gustavostuff/makineat/img/references/AI_concept_v_04.jpg

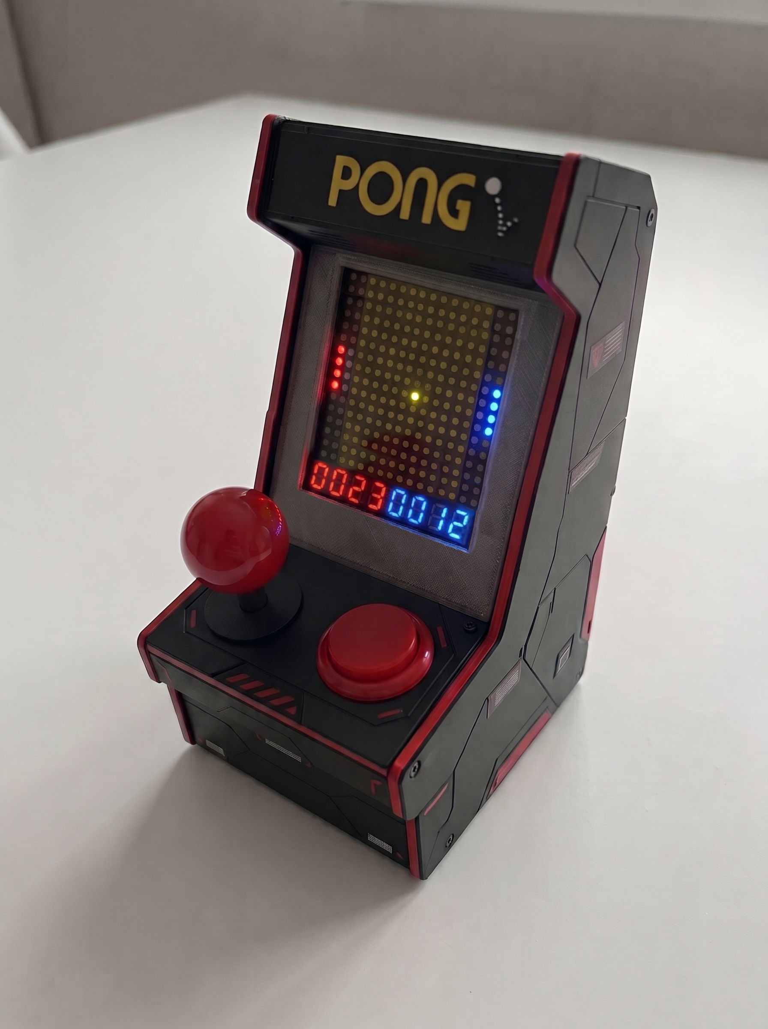
img/references/AI_concept_v_04.jpg
