gustavostuff/makineat/tools/kicad/cart-pcb/makineat-cart_v_02.png

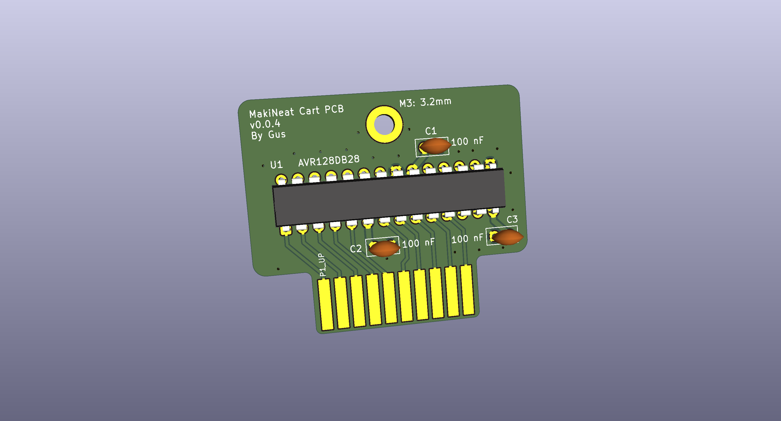
tools/kicad/cart-pcb/makineat-cart_v_02.png
