gustavostuff/makineat/tools/kicad/cart-pcb/makineat-cart_v_02.kicad_pcb

## KiCad design tools/kicad/cart-pcb/makineat-cart_v_02.kicad_pcb (2026-11-09)

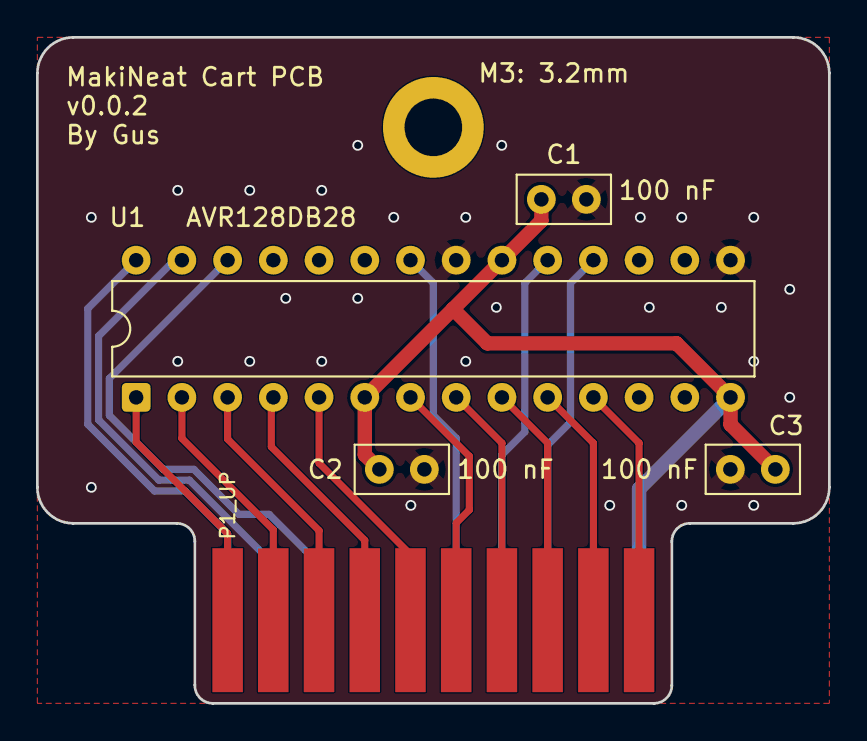
[picture p13: board makineat-cart_v_02.kicad_pcb from above]

Board: 2 copper layers, 44.0 x 37.0 mm, 6 parts (0 on the bottom side), 18 nets.

Parts:
C1, C2, C3: 100 nF; C_Disc_D5.0mm_W2.5mm_P2.50mm
Hole: M3: 3.2mm; MountingHole_3.2mm_M3_DIN965_Pad
J1: Cart edge 2x10; Cart_Edge_2x10_P2.54mm
U1: AVR128DB28; DIP-28_W7.62mm

Connections:
+5V: C1.1, C2.1, C3.1, J1.B10, U1.6, U1.14, U1.20
CLK: J1.B1, U1.28
DIN: J1.B3, U1.26
EVENT: J1.B8, U1.18
GND: C1.2, C2.2, C3.2, J1.B4, J1.B5, J1.B9, U1.15, U1.21
LOAD: J1.B2, U1.27
P1_BTN: J1.A5, U1.5
P1_DOWN: J1.A2, U1.2
P1_LEFT: J1.A3, U1.3
P1_RIGHT: J1.A4, U1.4
P1_UP: J1.A1, U1.1
P2_BTN: J1.A10, U1.11
P2_DOWN: J1.A7, U1.8
P2_LEFT: J1.A8, U1.9
P2_RIGHT: J1.A9, U1.10
P2_UP: J1.A6, U1.7
RESET: J1.B7, U1.19
UPDI: J1.B6, U1.22
