gustavostuff/makineat/tools/sim/seven_seg.c

#include "seven_seg.h"

#include "chips/max7219.h"

static SevenSegLayerBlitFn layer_blit;

#include <SDL_image.h>
#include <stdio.h>
#include <string.h>

static SDL_Texture *load_layer(SDL_Renderer *renderer, const char *name)
{
    char path[1024];
    char *base = SDL_GetBasePath();
    SDL_Surface *surface;
    SDL_Texture *tex;

    if (base != NULL) {
        snprintf(path, sizeof path, "%simg/7_segment_display_layers/%s", base, name);
        surface = IMG_Load(path);
        if (surface == NULL) {
            snprintf(path, sizeof path, "%s../sim/img/7_segment_display_layers/%s", base, name);
            surface = IMG_Load(path);
        }
        SDL_free(base);
    } else {
        surface = NULL;
    }
    if (surface == NULL) {
        snprintf(path, sizeof path, "tools/sim/img/7_segment_display_layers/%s", name);
        surface = IMG_Load(path);
    }
    if (surface == NULL) {
        SDL_Log("seven_seg IMG_Load %s failed: %s", name, IMG_GetError());
        return NULL;
    }
    tex = SDL_CreateTextureFromSurface(renderer, surface);
    SDL_FreeSurface(surface);
    if (tex != NULL)
        SDL_SetTextureScaleMode(tex, SDL_ScaleModeNearest);
    return tex;
}

static int texture_size(SDL_Texture *tex, int *w, int *h)
{
    if (tex == NULL || w == NULL || h == NULL)
        return -1;
    if (SDL_QueryTexture(tex, NULL, NULL, w, h) != 0)
        return -1;
    return 0;
}

static int layer_matches_digit(const SevenSegDisplay *disp, SDL_Texture *tex, const char *name)
{
    int w;
    int h;

    if (texture_size(tex, &w, &h) != 0)
        return -1;
    if (w != disp->digit_w || h != disp->digit_h) {
        SDL_Log("seven_seg layer %s is %dx%d, expected %dx%d", name, w, h, disp->digit_w,
                disp->digit_h);
        return -1;
    }
    return 0;
}

void seven_seg_set_layer_blit(SevenSegLayerBlitFn fn)
{
    layer_blit = fn;
}

int seven_seg_init(SevenSegDisplay *disp, SDL_Renderer *renderer)
{
    static const char *seg_files[7] = {
        "a.png", "b.png", "c.png", "d.png", "e.png", "f.png", "g.png",
    };
    int i;

    memset(disp, 0, sizeof *disp);
    disp->base = load_layer(renderer, "all_off.png");
    if (disp->base == NULL)
        return -1;
    if (texture_size(disp->base, &disp->digit_w, &disp->digit_h) != 0)
        return -1;
    for (i = 0; i < 7; i++) {
        disp->seg[i] = load_layer(renderer, seg_files[i]);
        if (disp->seg[i] == NULL)
            return -1;
        if (layer_matches_digit(disp, disp->seg[i], seg_files[i]) != 0)
            return -1;
    }
    disp->dp = load_layer(renderer, "dp.png");
    if (disp->dp == NULL)
        return -1;
    if (layer_matches_digit(disp, disp->dp, "dp.png") != 0)
        return -1;
    seven_seg_clear(disp);
    return 0;
}

void seven_seg_quit(SevenSegDisplay *disp)
{
    int i;

    if (disp->base != NULL) {
        SDL_DestroyTexture(disp->base);
        disp->base = NULL;
    }
    for (i = 0; i < 7; i++) {
        if (disp->seg[i] != NULL) {
            SDL_DestroyTexture(disp->seg[i]);
            disp->seg[i] = NULL;
        }
    }
    if (disp->dp != NULL) {
        SDL_DestroyTexture(disp->dp);
        disp->dp = NULL;
    }
}

void seven_seg_clear(SevenSegDisplay *disp)
{
    memset(disp->mask, 0, sizeof disp->mask);
}

void seven_seg_set_mask(SevenSegDisplay *disp, int digit, uint8_t mask)
{
    if (digit < 0 || digit >= SEVEN_SEG_DIGITS)
        return;
    disp->mask[digit] = mask;
}

uint8_t seven_seg_get_mask(const SevenSegDisplay *disp, int digit)
{
    if (digit < 0 || digit >= SEVEN_SEG_DIGITS)
        return 0;
    return disp->mask[digit];
}

uint8_t seven_seg_mask_from_max7219(uint8_t segment_byte)
{
    uint8_t mask = 0;

    if ((segment_byte & 0x40) != 0)
        mask |= SEVEN_SEG_A;
    if ((segment_byte & 0x20) != 0)
        mask |= SEVEN_SEG_B;
    if ((segment_byte & 0x10) != 0)
        mask |= SEVEN_SEG_C;
    if ((segment_byte & 0x08) != 0)
        mask |= SEVEN_SEG_D;
    if ((segment_byte & 0x04) != 0)
        mask |= SEVEN_SEG_E;
    if ((segment_byte & 0x02) != 0)
        mask |= SEVEN_SEG_F;
    if ((segment_byte & 0x01) != 0)
        mask |= SEVEN_SEG_G;
    if ((segment_byte & 0x80) != 0)
        mask |= SEVEN_SEG_DP;
    return mask;
}

void seven_seg_sync_from_max7219(SevenSegDisplay *disp, const Max7219 *chip)
{
    int d;

    if (disp == NULL || chip == NULL)
        return;
    for (d = 0; d < SEVEN_SEG_DIGITS; d++)
        disp->mask[d] = seven_seg_mask_from_max7219(max7219_segment_byte(chip, d));
}

void seven_seg_sync_from_status_frame(SevenSegDisplay *disp, const uint8_t *frame, int n)
{
    int d;
    int count = n;

    if (disp == NULL || frame == NULL)
        return;
    if (count > SEVEN_SEG_DIGITS)
        count = SEVEN_SEG_DIGITS;
    for (d = 0; d < count; d++)
        disp->mask[d] = frame[d];
    for (; d < SEVEN_SEG_DIGITS; d++)
        disp->mask[d] = 0;
}

uint8_t seven_seg_encode_char(char c)
{
    return seven_seg_font_mask(c);
}

void seven_seg_put_char(SevenSegDisplay *disp, int digit, char c)
{
    seven_seg_set_mask(disp, digit, seven_seg_encode_char(c));
}

int seven_seg_print(SevenSegDisplay *disp, const char *text)
{
    int slot = 0;
    int last = -1;
    int n = 0;

    seven_seg_clear(disp);
    if (text == NULL)
        return 0;

    for (; *text != '\0' && slot < SEVEN_SEG_DIGITS; text++) {
        char c = *text;

        if (c == '.') {
            if (last >= 0)
                disp->mask[last] |= SEVEN_SEG_DP;
            continue;
        }
        disp->mask[slot] = seven_seg_encode_char(c);
        last = slot;
        slot++;
        n++;
    }
    return n;
}

static void blit_digit_layer(SDL_Renderer *renderer, SDL_Texture *tex, int x, int y, int src_w,
                             int src_h, int dst_w, int dst_h, int lit)
{
    SDL_Rect src = {0, 0, src_w, src_h};
    SDL_Rect dst = {x, y, dst_w, dst_h};

    if (tex == NULL || dst_w <= 0 || dst_h <= 0)
        return;
    if (layer_blit != NULL)
        layer_blit(renderer, tex, &src, &dst, lit);
    else
        SDL_RenderCopy(renderer, tex, &src, &dst);
}

void seven_seg_draw_digit(const SevenSegDisplay *disp, SDL_Renderer *renderer, int x, int y,
                          uint8_t mask, int scale)
{
    int bit;
    int src_w;
    int src_h;
    int dst_w;
    int dst_h;

    if (disp == NULL || disp->base == NULL || scale < 1)
        return;
    src_w = disp->digit_w;
    src_h = disp->digit_h;
    dst_w = src_w * scale;
    dst_h = src_h * scale;
    blit_digit_layer(renderer, disp->base, x, y, src_w, src_h, dst_w, dst_h, 0);
    for (bit = 0; bit < 7; bit++) {
        if ((mask & (1u << bit)) != 0)
            blit_digit_layer(renderer, disp->seg[bit], x, y, src_w, src_h, dst_w, dst_h, 1);
    }
    if ((mask & SEVEN_SEG_DP) != 0)
        blit_digit_layer(renderer, disp->dp, x, y, src_w, src_h, dst_w, dst_h, 1);
}

int seven_seg_row_width(const SevenSegDisplay *disp)
{
    if (disp == NULL || disp->digit_w <= 0)
        return 0;
    return disp->digit_w * SEVEN_SEG_DIGITS;
}

void seven_seg_draw(const SevenSegDisplay *disp, SDL_Renderer *renderer, int x, int y,
                    int canvas_w, int canvas_h)
{
    int i;
    SDL_Rect old;
    SDL_Rect clip = {0, 0, canvas_w, canvas_h};
    SDL_bool enabled;

    if (disp == NULL || disp->digit_w <= 0)
        return;

    enabled = SDL_RenderIsClipEnabled(renderer);
    SDL_RenderGetClipRect(renderer, &old);
    SDL_RenderSetClipRect(renderer, &clip);
    for (i = 0; i < SEVEN_SEG_DIGITS; i++)
        seven_seg_draw_digit(disp, renderer, x + i * disp->digit_w, y, disp->mask[i], 1);
    if (enabled)
        SDL_RenderSetClipRect(renderer, &old);
    else
        SDL_RenderSetClipRect(renderer, NULL);
}

int seven_seg_below_field_origin(const SevenSegDisplay *disp, int field_x, int field_y,
                                 int field_px, int grid_margin, int *out_x, int *out_y)
{
    int row_w;
    int avail;
    int x;
    int y;

    if (disp == NULL || disp->digit_w <= 0 || out_x == NULL || out_y == NULL)
        return -1;

    row_w = seven_seg_row_width(disp);
    y = field_y + field_px + grid_margin;
    avail = field_px - 2 * grid_margin;
    if (row_w <= avail)
        x = field_x + grid_margin + (avail - row_w) / 2;
    else
        x = field_x + (field_px - row_w) / 2;
    *out_x = x;
    *out_y = y;
    return 0;
}

void seven_seg_draw_below_field(const SevenSegDisplay *disp, SDL_Renderer *renderer,
                                int field_x, int field_y, int field_px, int grid_margin,
                                int canvas_w, int canvas_h)
{
    int x;
    int y;

    if (seven_seg_below_field_origin(disp, field_x, field_y, field_px, grid_margin, &x, &y) != 0)
        return;
    seven_seg_draw(disp, renderer, x + SEVEN_SEG_LAYER_X_OFFSET, y, canvas_w, canvas_h);
}
