gustavostuff/makineat/tools/fw/stage.h

#ifndef FW_STAGE_H
#define FW_STAGE_H

/*
 * Platform stages: wide/tall bitmaps with a scrolling camera over the 16x16
 * field. PNG import (tools/fw/gen_stage.py): pure colors on fg (see docs/firmware.md
 * Stage section). Optional bg parallax maps scroll spans so both layers start and
 * end together: bg moves (bg_width - 16) / (fg_width - 16) per fg camera step.
 * Horizontal mode is implemented. Vertical
 * mode is stubbed (STAGE_ERR_UNSUPPORTED).
 */

#include "frame.h"

#include <stdint.h>

#define STAGE_TICK_HZ 60
#define STAGE_SCROLL_FPS 30

/* Horizontal camera dead zone in screen space (see stage_h_camera_follow_dead_zone). */
#define STAGE_H_DEAD_ZONE_X 5
#define STAGE_H_DEAD_ZONE_W 6

/* Pure yellow (255,255,0) item containers. Each one is a 2x2. */
#define STAGE_ITEM_MAX 32
#define STAGE_ITEM_BOUNCE_TICKS 8
/* Unused containers cycle four shine patterns. The first holds for 1 second. */
#define STAGE_ITEM_SHINE_FRAMES 4
#define STAGE_ITEM_SHINE_HOLD_LONG STAGE_TICK_HZ
/* The other three patterns hold for 0.1 second, which is 6 ticks at 60 Hz. */
#define STAGE_ITEM_SHINE_HOLD_SHORT 6

#define STAGE_ITEM_KIND_COIN 0
#define STAGE_ITEM_KIND_GROWTH 1

#define STAGE_PICKUP_MAX 4
#define STAGE_PICKUP_HORIZ_FPS 4

typedef enum {
    STAGE_SCROLL_H,
    STAGE_SCROLL_V,
} StageScrollMode;

#define STAGE_ERR_UNSUPPORTED (-1)

typedef enum {
    STAGE_BUMP_NONE = 0,
    STAGE_BUMP_COIN = 1,
    STAGE_BUMP_GROWTH = 2,
} StageBumpResult;

typedef struct StageItem {
    uint16_t x;
    uint16_t y;
    uint8_t kind; /* STAGE_ITEM_KIND_COIN or STAGE_ITEM_KIND_GROWTH */
} StageItem;

typedef struct StagePickup {
    int16_t active;
    int16_t px;
    int16_t py;
    int vy;
    int walk_accum;
    int vert_accum;
    int grounded;
    int8_t dir; /* -1 or +1 world steps */
    uint8_t fall_on;
    uint8_t fall_i;
    uint8_t fall_timer;
} StagePickup;

typedef struct StageMap {
    uint16_t width;
    uint16_t height;
    uint16_t row_words;
    uint16_t spawn_x;
    uint16_t spawn_y;
    const uint16_t *fg_lit;
    const uint16_t *fg_solid;
    const uint16_t *fg_semisolid; /* 1-cell-thick platforms (gray); lit like decor, special vertical rules */
    uint16_t bg_width;
    uint16_t bg_row_words;
    const uint16_t *bg_lit;
    uint16_t item_count;
    const StageItem *items;
    const uint16_t *fg_goal; /* pure magenta (255,0,255): drawn, not solid, clears the stage */
} StageMap;

typedef struct StageView {
    StageScrollMode mode;
    const StageMap *map;
    int camera;
    int bg_camera;
    int draw_bg; /* 0 skips background pixels. Parallax camera math still runs. */
    int scroll_accum;
    int dead_zone_x; /* screen column of left edge (0-based), full FIELD_SIZE height */
    int dead_zone_w; /* width in screen columns */
    uint8_t item_bounce[STAGE_ITEM_MAX]; /* ticks left with the 2x2 drawn one cell up */
    uint8_t item_used[STAGE_ITEM_MAX]; /* 1 after the first bump: solid, no shine, no bounce */
    uint8_t growth_pickup_spawned[STAGE_ITEM_MAX]; /* 1 after growth pickup left the block */
    uint8_t item_shine; /* pattern index shared by unused containers */
    uint8_t item_shine_age; /* ticks the current pattern has been shown, including this tick */
    StagePickup pickups[STAGE_PICKUP_MAX];
} StageView;

int stage_map_get(const StageMap *map, int x, int y);
int stage_map_lit(const StageMap *map, int x, int y);
int stage_map_solid(const StageMap *map, int x, int y);
int stage_map_semisolid(const StageMap *map, int x, int y);
int stage_map_goal(const StageMap *map, int x, int y);
int stage_item_covers(const StageMap *map, int x, int y);
int stage_growth_covers(const StageMap *map, int x, int y);

void stage_view_init(StageView *view);

int stage_bind_h(StageView *view, const StageMap *map);
int stage_bind_v(StageView *view, const StageMap *map);

int stage_h_camera_max(const StageView *view);
int stage_h_bg_camera_max(const StageView *view);
int stage_h_camera_get(const StageView *view);
int stage_h_bg_camera_get(const StageView *view);
void stage_h_camera_set(StageView *view, int x);
void stage_h_camera_follow_dead_zone(StageView *view, int world_x);

/* dx is -1, 0, or +1 (world moves opposite stick). Steps at STAGE_SCROLL_FPS. */
void stage_h_scroll_tick(StageView *view, int dx);

void stage_h_paint(const StageView *view);
/* 1 when the player LED must stay off: green fg decor, or bg art with no solid fg. */
int stage_h_suppress_player_led(const StageView *view, int world_x, int world_y);
/*
 * Like stage_h_paint, but when hide_player_fg is non-zero the cell at world
 * (hide_world_x, hide_world_y) skips ON for green fg decor and for bg when fg is not solid
 * red. Foreground always wins over background for the ON bit in one pass so bg never stacks
 * under fg on the same LED. Red solid fg can still sit over bg without double brightness.
 */
/*
 * hide_player_h is 1 or 2. When 2, both (hide_world_x, hide_world_y) and
 * (hide_world_x, hide_world_y - 1) use the player hide rules for decor and bg dimming.
 */
void stage_h_paint_ex(const StageView *view, int hide_world_x, int hide_world_y, int hide_player_fg,
    int hide_player_h);
int stage_h_solid(const StageView *view, int world_x, int world_y);
/* Horizontal body probe: red + item cells only (semisolid is pass-through sideways). */
int stage_h_blocks_horiz(const StageView *view, int world_x, int world_y);
/*
 * Vertical step into (world_x, world_y). prev_feet_y is the feet row before the step;
 * dy is -1 moving up or +1 moving down. Semisolid (#808080 ledges) blocks a downward
 * step into the cell and allows an upward step through it.
 */
int stage_h_blocks_vert(const StageView *view, int world_x, int world_y, int prev_feet_y, int dy);
/* Vertical probe for a body cell that must not treat semisolid as a ceiling (e.g. tall head while feet land). */
int stage_h_blocks_vert_hard(const StageView *view, int world_x, int world_y);
/*
 * Solid for movement probes, excluding other pickups so two pickups never block each other.
 * Pass ignore_pickup_index -1 to ignore none, or a slot index to skip that pickup only.
 */
int stage_h_pickup_blocked(const StageView *view, int world_x, int world_y, int ignore_pickup_index);
void stage_h_items_tick(StageView *view);
/* Fresh hit from below. */
StageBumpResult stage_h_item_bump(StageView *view, int x, int y);
/*
 * If a growth pickup overlaps the player feet at (px, py) or head at (px, py-1) when
 * player_h is 2, consumes it and returns 1.
 */
int stage_h_collect_growth_pickup(StageView *view, int px, int py, int player_h);

int stage_v_camera_max(const StageView *view);
void stage_v_scroll_tick(StageView *view, int dy);
void stage_v_paint(const StageView *view);

#endif
