gustavostuff/makineat/tools/fw/text.h

#ifndef FW_TEXT_H
#define FW_TEXT_H

/*
 * Shared 4x4 glyphs (3x3 font with 1px right and bottom margin).
 * Digits 0-9, letters A-Z, dot, comma, colon, semicolon, -, +, =, and /.
 * A letter uses its own glyph, then the other case. A missing character is not drawn.
 * A space is a blank cell.
 *
 * text_print paints one line from column x, row y. Each glyph takes its
 * cell (four columns, or eight when scale is TEXT_SCALE_2) plus
 * character_spacing font pixels before the next glyph. The usual gap is
 * TEXT_CHAR_SPACING_DEFAULT (1). Pass 0 for no extra gap. Spacing grows
 * with scale. Pixels past the field are ignored.
 * text_print_outline first stamps each glyph pixel OFF in the eight
 * neighbor cells, then draws the glyphs ON. Blink inverts those two
 * passes at TEXT_BLINK_FPS_DEFAULT.
 *
 * print_scroll advances and draws clipped scrolling text. Configure the
 * TextScroll fields before text_scroll_start, then call print_scroll
 * once per 60 Hz frame. Set TextScroll.font to TEXT_FONT_LARGE for the
 * 5×6 set (see text_large.h). Set TextScroll.scale to TEXT_SCALE_2 for
 * 2×2 pixels per font pixel on either font; scroll_x still moves one
 * field pixel per step. character_spacing is the same gap as text_print.
 * A zeroed field becomes TEXT_CHAR_SPACING_DEFAULT when the scroll starts.
 * margin_left and margin_right add empty field
 * pixels before the first glyph and after the last (included in bounce travel).
 * print_scroll_outline does the same with a 1px ring; print_scroll_outline_blink
 * also inverts that ring with TextBlink.
 */

#include "text_large.h"

#include <stdint.h>

#define TEXT_W 4
#define TEXT_H 4
#define TEXT_FIELD_W 16
#define TEXT_FRAME_HZ 60
#define TEXT_SCROLL_SPEED_FPS_DEFAULT 15
#define TEXT_SCROLL_PAUSE_DEFAULT 60
#define TEXT_SCROLL_VIEW_W_DEFAULT TEXT_FIELD_W
#define TEXT_SCROLL_VIEW_H_DEFAULT TEXT_H
#define TEXT_BLINK_FPS_DEFAULT 2
#define TEXT_SCALE_1 1
#define TEXT_SCALE_2 2
#define TEXT_CHAR_SPACING_DEFAULT 1

typedef enum {
    TEXT_FONT_DEFAULT = 0,
    TEXT_FONT_LARGE,
} TextFont;

typedef enum {
    TEXT_SCROLL_BOUNCE,
    TEXT_SCROLL_RESET,
} TextScrollRepeat;

typedef struct TextScroll {
    const char *text;
    int x;
    int y;
    int viewport_w;
    int viewport_h;
    int speed_fps;
    int pause_frames;
    TextScrollRepeat repeat;
    TextFont font;
    int scale;
    int character_spacing; /* 0 at start selects TEXT_CHAR_SPACING_DEFAULT */
    int margin_left;
    int margin_right;
    int scroll_x;
    int dir;
    int wait;
    int step;
    int pending_reset;
    int saw_far_edge;
    int bounce_done;
    int far_done; /* TEXT_SCROLL_BOUNCE: set when the pause at the far edge ends */
} TextScroll;

typedef struct TextBlink {
    int fps;
    int step;
    int invert;
} TextBlink;

const uint8_t *text_glyph(char c);

void text_draw(int x, int y, const char *s, int character_spacing);
void text_print(int x, int y, const char *s, int character_spacing);
void text_draw_scaled(int x, int y, int scale, const char *s, int character_spacing);
void text_print_scaled(int x, int y, int scale, const char *s, int character_spacing);

/*
 * Outline punches a 1px OFF ring (8 neighbors) then draws the glyphs ON.
 * Blink inverts that: the ring is ON and the glyphs are OFF. Default 2 FPS.
 */
void text_draw_outline(int x, int y, const char *s, int character_spacing, int invert);
void text_print_outline(int x, int y, const char *s, int character_spacing);
void text_blink_start(TextBlink *tb);
void text_blink_advance(TextBlink *tb);
void text_print_outline_blink(int x, int y, const char *s, int character_spacing, TextBlink *tb);

void text_scroll_start(TextScroll *ts, int x, int y, const char *text);
void text_scroll_stop(TextScroll *ts);
/* TEXT_SCROLL_BOUNCE: set when a full out-and-back scroll finishes its home pause. */
int text_scroll_take_bounce_done(TextScroll *ts);
/* TEXT_SCROLL_BOUNCE: set when the pause after scrolling to the far edge ends. */
int text_scroll_take_far_done(TextScroll *ts);
void text_scroll_advance(TextScroll *ts);
void text_scroll_paint(const TextScroll *ts);
void text_scroll_paint_outline(const TextScroll *ts, int invert);
void print_scroll(TextScroll *ts);
void print_scroll_outline(TextScroll *ts);
void print_scroll_outline_blink(TextScroll *ts, TextBlink *tb);

#endif
