gustavostuff/makineat/tools/fw/seven_seg_font_table.h

/* Glyph table written by tools/seven-seg-font from seven_seg_font.json. */
#ifndef SEVEN_SEG_FONT_TABLE_H
#define SEVEN_SEG_FONT_TABLE_H

#include "seven_seg_font.h"

const SevenSegGlyph seven_seg_font[] = {
    { '0', 0x3F },
    { '1', 0x06 },
    { '2', 0x5B },
    { '3', 0x4F },
    { '4', 0x66 },
    { '5', 0x6D },
    { '6', 0x7D },
    { '7', 0x07 },
    { '8', 0x7F },
    { '9', 0x6F },
    { 'A', 0x77 },
    { 'b', 0x7C },
    { 'C', 0x39 },
    { 'D', 0x5E },
    { 'E', 0x79 },
    { 'f', 0x71 },
    { 'g', 0x3D },
    { 'h', 0x76 },
    { 'i', 0x06 },
    { 'J', 0x0E },
    { 'l', 0x38 },
    { 'n', 0x37 },
    { 'o', 0x3F },
    { 'p', 0x73 },
    { 'q', 0x67 },
    { 's', 0x6D },
    { 'u', 0x3E },
    { 'z', 0x5B },
    { '-', 0x40 },
    { '.', 0x80 },
};

const int seven_seg_font_count = 30;

#endif
