gustavostuff/makineat/tools/fw/status.h

#ifndef FW_STATUS_H
#define FW_STATUS_H

#include <stdint.h>

void status_clear(void);
void status_set_digit(uint8_t digit, uint8_t value);
uint8_t status_get_digit(uint8_t digit);

/* 0xFF is Code-B (scores). 0x00 is raw segment bits (title sine). */
void status_set_decode(uint8_t mask);
uint8_t status_decode(void);

/* Digit register bytes for drivers_flush (Code-B data, no address). */
const uint8_t *status_digits(void);

#endif
