gustavostuff/makineat/(commit log)

2026-10-31 2 header connectors for 7-seg displays
    [makineat_v_04.kicad_pcb, makineat_v_05.kicad_pcb]
2026-11-01 Copper tracing done-ish for main PCB (v05)
    [makineat_v_05.kicad_pcb]
2026-11-01 Doc updates
    [makineat_v_05.kicad_pcb]
2026-11-01 Main PCB v0.0.5
    [makineat_v_05.kicad_pcb]
2026-11-01 Cart is not loaded from the top/roof
    [makineat-cart.kicad_pcb, makineat_v_05.kicad_pcb]
2026-11-01 Added 7-segment displays datasheet
    [makineat_v_05.kicad_pcb]
2026-11-01 Fixed DRC errors in main PCB
    [7_segment_display_v_01.kicad_pcb, makineat_v_05.kicad_pcb]
2026-11-02 Fixed PCB images in README
    [7_segment_display_v_01.kicad_pcb, makineat_v_05.kicad_pcb]
2026-11-02 Add details about cartridge and LED matrices
2026-11-02 Working on 7-segment digits UI
    [makineat-cart.kicad_pcb]
2026-11-02 Fixed acetate bugs on Sim tool
    [acetate.c, acetate.h, main.c, over.c, over.h]
2026-11-03 Back to perpendicular cart edge (J3)
    [makineat-cart.kicad_pcb, makineat_v_05.kicad_pcb]
2026-11-03 Updated imgs and main PCB
    [makineat_v_05.kicad_pcb]
2026-11-03 Fixed bugs witn pong game
    [cart.c, cart.h, input.c, input.h, main.c, over.c, over.h, persist.c]
2026-11-03 Polished Pong game
    [makineat_v_05.kicad_pcb]
2026-11-03 Refactored acetate edit flow
2026-11-04 More dynamic ball bounce (Pong)
    [makineat_v_05.kicad_pcb]
2026-11-04 Logo update + fixed DRC on KiCad
    [makineat_v_05.kicad_pcb]
2026-11-04 Added PCB logo
    [makineat_v_05.kicad_pcb]
2026-11-04 Via GND stitches + power budget
    [makineat_v_05.kicad_pcb]
2026-11-04 More docs and updated PCB images
    [makineat-cart_v_02.kicad_pcb, makineat_v_05.kicad_pcb]
2026-11-06 Fixing player falling accel
    [gen_stage.py, plat_physics.c, plat_physics.h, platform.c, platform.h, stage.c, stage.h]
2026-11-06 More solid 'Super LED Bros'
2026-11-06 Fixed 'game over' in Super LED Bros
    [over.c, super_led_bros.c, super_led_bros.h, test.c, text.c, text.h]
2026-11-07 Minot fixes here and there
    [test.c]
2026-11-07 Fixed 'pong' letter in 7-segment display
    [test.c]
2026-11-08 Updated logos, PCB and docs
    [makineat_v_06.kicad_pcb]
2026-11-08 Improved Super LED bros a bit
2026-11-08 Polsihed matrix 3D model + fixed R25 in main PCB
    [makineat_v_06.kicad_pcb]
2026-11-09 fixed 7-segment editor tool issues
    [main.c]
2026-11-09 Updated images in main README
    [makineat-cart_v_02.kicad_pcb, makineat_v_06.kicad_pcb]
2026-11-10 Adding test points and debug LEDs
    [makineat_v_07.kicad_pcb]
2026-11-10 Polishing test points related stuff
    [makineat_v_07.kicad_pcb]
2026-11-10 Updated main README imgs
    [makineat_v_07.kicad_pcb]
2026-11-11 Updated logos
    [makineat_v_07.kicad_pcb]
2026-11-11 Small updates to main PCB
    [makineat_v_07.kicad_pcb]
2026-11-13 7-segment glyphs are now JSON
    [makineat_v_08.kicad_pcb]
2026-11-13 Fixed ship position in space shooter
    [makineat_v_08.kicad_pcb]
